thedini/NEMO/PCB/NEMO.kicad_sch

## KiCad design PCB/NEMO.kicad_sch (2026-02-18)

Schematic: NEMO.kicad_sch

Parts:
DS1: OLED_128X64_1.3_I2C; LCD_OLED_128X64_1.3_I2C; PARTREV NA
J1: 282837-3; TE_282837-3; PARTREV H
J2: 54-00387; NMEA2000; PARTREV A
J3: MicroSD_Breakout; MicroSD_Breakout_1x06
R1, R2, R3: RV09AF-40-20K-A10K; TRIM_RV09AF-40-20K-A10K; PARTREV N/A
SW1, SW2, SW3, SW4: 1825910-6; SW_1825910-6-4; PARTREV C10
U1: DEV-15583; MODULE_DEV-15583
U2, U3: CAN_CHIP
