thedini/NEMO/(commit log)

2026-02-17 Add design context for micro SD card slot addition
    Documents the full plan for adding a micro SD card to the NEMO PCB:
    pin assignments (SPI0 pins 10-13, all free), KiCad schematic/layout
    steps, firmware changes (SdFat library, logging integration), and a
    task checklist for both PCB and firmware work.
2026-02-18 Add microSD breakout connector (J3) to schematic
    - Add 6-pin header symbol and footprint for SPI breakout module
    - Wire to Teensy pins 10 (CS), 11 (MOSI), 12 (MISO), 13 (SCK)
    - Add net labels: SD_CS, SD_MOSI, SD_MISO, SD_SCK
    - Document Amazon breakout options in MicroSD_Card_Addition.md
    - Add .claude/ to gitignore
    [NEMO.kicad_sch]
2026-02-21 Add Serial_Controller for JSON-line GUI communication
    Adds Serial_Controller library enabling bidirectional JSON-line protocol
    over USB serial for the OpenBridge desktop GUI. Supports sensor control,
    attack start/stop, raw CAN injection, network monitor queries, and CAN2
    traffic streaming. Sensor class extended with setValue(), setActive(),
    setSerialControlled(), and manufacturer code setters. ArduinoJson added
    as dependency.
2026-10-08 Fix attack spam address-claim flood to actually transmit (D25)
    The spam/DoS positive control sent essentially nothing. startSpamAttack()
    had its prime loop commented out and Attack_Controller::update() had no
    spam branch, so the only transmit path was the reactive attackHandler()
    replying to inbound PGN 60928 claims -- which on a quiet bench bus fired
    rarely or never. Combined with loop() suspending sensor transmit during
    attacks, the "LOUD" window was really ~30 s of silence from the injector
    source addresses (0x19-0x1B).
    - Add updateSpam(), driven from update() every loop iteration, emitting a
    millis()-paced ISO Address-Claim flood at a configurable rate (default
    100 fps, hard cap 100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
    [main.cpp]
